frischerZucker/trichter/README.md

# SMART-TRICHTER

## Setup
This project uses [u8g2](https://github.com/olikraus/u8g2) as graphiics library.
Clone it to your machine and copy its include (\*.h) and source (\*.c) files from `u8g2/csrc` to `./software/trichter_firmware/Inc` and  `./software/trichter_firmware/.`
