frischerZucker/trichter/hardware/trichter_bom.xlsx

Anzahl Boards: | 2 | Lieferant | Teilenummer | Beschreibung | Stück pro Board | Stück benötigt | Stückpreis | Preis
 |  | Digikey | 1597-1517-ND | flow sensor | 1 | 3 | 6.90 € | 20.70 €
Gesamtpreis: | 75.04 € | Digikey | 2073-USB4110-GF-A-1-ND | USB-C receptacle | 1 | 3 | 1.27 € | 3.81 €
 |  | Digikey | CKN9087CT-ND | button | 5 | 11 | 0.31 € | 3.44 €
 |  | Digikey | 2449-ANT11SF1CQE-ND | switch | 1 | 3 | 2.36 € | 7.08 €
 |  | Digikey | AP7361C-33E-13DICT-ND | voltage regulator 5V -> 3.3V | 1 | 3 | 0.55 € | 1.65 €
 |  | Digikey | 497-STM32C051K8T6-ND | microcontroller | 1 | 3 | 1.60 € | 4.80 €
 |  | Digikey | 475-KBEELP41.12-P1R2-36-3X4X-5-R18CT-ND | LED, 5mA@2.75V | 2 | 5 | 0.18 € | 0.90 €
 |  | Digikey | 490-10503-1-ND | C, 10uF | 25 | 51 | 0.10 € | 5.05 €
 |  | Digikey | 1276-1248-1-ND | C, 4.7uF | 25 | 51 | 0.11 € | 5.42 €
 |  | Digikey | 1276-1033-1-ND | C, 100nF | 25 | 51 | 0.02 € | 1.19 €
 |  | Digikey | RMCF0603FT10K0CT-ND | R, 10k | 25 | 51 | 0.01 € | 0.61 €
 |  | Digikey | RMCF0603FT5K10CT-ND | R, 5.1k | 25 | 51 | 0.01 € | 0.61 €
 |  | Digikey | RMCF0603FT390RCT-ND | R, 390 | 25 | 51 | 0.01 € | 0.61 €
 |  | Digikey | 2057-PH1-20-UA-ND | Pinheader 01x20 | 5 | 11 | 0.22 € | 2.44 €
 |  | Digikey | 35-PRPC010DAAN-RC-ND | Pinheader 02x10 | 5 | 11 | 0.33 € | 3.58 €
 |  | Digikey | M7581-46-ND | Jumper | 18 | 37 | 0.06 € | 2.37 €
 |  | Digikey | 4272-PTS-00210-211-ND | USB to UART | 0 | 1 | 10.78 € | 10.78 €
