frischerZucker/trichter/software/trichter_firmware/Src/main.c

#include "main.h"

#include "stdio.h"
#include "string.h"

#include "display.h"
#include "flash.h"
#include "flow_sensor.h"
#include "menu.h"
#include "trichter_state.h"
#include "user_profile.h"

#define ENCODER_DEBOUNCE_TIME_MS 50

static I2C_HandleTypeDef hi2c1;

static UART_HandleTypeDef huart1;

static flow_sensor_state_t flow_sensor;

static trichter_state_t state = STATE_IDLE;

static bool btn_back = false;
static bool last_btn_back = false;
static bool btn_confirm = false;
static bool last_btn_confirm = false;

static bool drinking_started = false;

static bool display_dirty = true;

static uint32_t encoder_last_tick = 0;
static int encoder_delta = 0;

static char new_user_name[USER_PROFILE_MAX_NAME_LEN + 1];
static size_t new_user_name_idx;

static void system_clock_init(void)
{
	RCC_OscInitTypeDef RCC_OscInitStruct =
	{ 0 };
	RCC_ClkInitTypeDef RCC_ClkInitStruct =
	{ 0 };

	__HAL_FLASH_SET_LATENCY(FLASH_LATENCY_0);

	RCC_OscInitStruct.OscillatorType = RCC_OSCILLATORTYPE_HSI;
	RCC_OscInitStruct.HSIState = RCC_HSI_ON;
	RCC_OscInitStruct.HSIDiv = RCC_HSI_DIV1;
	RCC_OscInitStruct.HSICalibrationValue = RCC_HSICALIBRATION_DEFAULT;
	if (HAL_RCC_OscConfig(&RCC_OscInitStruct) != HAL_OK)
	{
		Error_Handler();
	}

	RCC_ClkInitStruct.ClockType = RCC_CLOCKTYPE_HCLK | RCC_CLOCKTYPE_SYSCLK | RCC_CLOCKTYPE_PCLK1;
	RCC_ClkInitStruct.SYSCLKSource = RCC_SYSCLKSOURCE_HSI;
	RCC_ClkInitStruct.SYSCLKDivider = RCC_SYSCLK_DIV1;
	RCC_ClkInitStruct.AHBCLKDivider = RCC_HCLK_DIV1;
	RCC_ClkInitStruct.APB1CLKDivider = RCC_APB1_DIV1;

	if (HAL_RCC_ClockConfig(&RCC_ClkInitStruct, FLASH_LATENCY_0) != HAL_OK)
	{
		Error_Handler();
	}
}

static void i2c_init(void)
{
	hi2c1.Instance = I2C1;
	hi2c1.Init.Timing = 0x0090194B;
	hi2c1.Init.OwnAddress1 = 0;
	hi2c1.Init.AddressingMode = I2C_ADDRESSINGMODE_7BIT;
	hi2c1.Init.DualAddressMode = I2C_DUALADDRESS_DISABLE;
	hi2c1.Init.OwnAddress2 = 0;
	hi2c1.Init.OwnAddress2Masks = I2C_OA2_NOMASK;
	hi2c1.Init.GeneralCallMode = I2C_GENERALCALL_DISABLE;
	hi2c1.Init.NoStretchMode = I2C_NOSTRETCH_DISABLE;
	if (HAL_I2C_Init(&hi2c1) != HAL_OK)
	{
		Error_Handler();
	}

	if (HAL_I2CEx_ConfigAnalogFilter(&hi2c1, I2C_ANALOGFILTER_ENABLE) != HAL_OK)
	{
		Error_Handler();
	}

	if (HAL_I2CEx_ConfigDigitalFilter(&hi2c1, 0) != HAL_OK)
	{
		Error_Handler();
	}
}

static void uart_init(void)
{
	huart1.Instance = USART1;
	huart1.Init.BaudRate = 115200;
	huart1.Init.WordLength = UART_WORDLENGTH_8B;
	huart1.Init.StopBits = UART_STOPBITS_1;
	huart1.Init.Parity = UART_PARITY_NONE;
	huart1.Init.Mode = UART_MODE_TX_RX;
	huart1.Init.HwFlowCtl = UART_HWCONTROL_NONE;
	huart1.Init.OverSampling = UART_OVERSAMPLING_16;
	huart1.Init.OneBitSampling = UART_ONE_BIT_SAMPLE_DISABLE;
	huart1.Init.ClockPrescaler = UART_PRESCALER_DIV1;
	huart1.AdvancedInit.AdvFeatureInit = UART_ADVFEATURE_NO_INIT;
	if (HAL_UART_Init(&huart1) != HAL_OK)
	{
		Error_Handler();
	}
	if (HAL_UARTEx_SetTxFifoThreshold(&huart1, UART_TXFIFO_THRESHOLD_1_8) != HAL_OK)
	{
		Error_Handler();
	}
	if (HAL_UARTEx_SetRxFifoThreshold(&huart1, UART_RXFIFO_THRESHOLD_1_8) != HAL_OK)
	{
		Error_Handler();
	}
	if (HAL_UARTEx_DisableFifoMode(&huart1) != HAL_OK)
	{
		Error_Handler();
	}
}

static void gpio_init(void)
{
	GPIO_InitTypeDef GPIO_InitStruct =
	{ 0 };

	__HAL_RCC_GPIOA_CLK_ENABLE();
	__HAL_RCC_GPIOB_CLK_ENABLE();

	GPIO_InitStruct.Pin = PIN_IO0 | PIN_BTN_CONFIRM | PIN_ENCODER_PUSH | PIN_ENCODER_B;
	GPIO_InitStruct.Mode = GPIO_MODE_INPUT;
	GPIO_InitStruct.Pull = GPIO_NOPULL;
	HAL_GPIO_Init(PORT_IO0, &GPIO_InitStruct);

	GPIO_InitStruct.Pin = PIN_FLOW_PULSE | PIN_ENCODER_A;
	GPIO_InitStruct.Mode = GPIO_MODE_IT_RISING;
	GPIO_InitStruct.Pull = GPIO_NOPULL;
	HAL_GPIO_Init(PORT_FLOW_PULSE, &GPIO_InitStruct);

	GPIO_InitStruct.Pin = PIN_BTN_BACK | PIN_IO5 | PIN_IO4 | PIN_IO3 | PIN_IO2 | PIN_IO1;
	GPIO_InitStruct.Mode = GPIO_MODE_INPUT;
	GPIO_InitStruct.Pull = GPIO_NOPULL;
	HAL_GPIO_Init(PORT_BTN_BACK, &GPIO_InitStruct);

	HAL_NVIC_SetPriority(EXTI0_1_IRQn, 0, 0);
	HAL_NVIC_EnableIRQ(EXTI0_1_IRQn);

	HAL_NVIC_SetPriority(EXTI4_15_IRQn, 0, 0);
	HAL_NVIC_EnableIRQ(EXTI4_15_IRQn);
}

static void menu_callback_remove_user(void)
{
	user_profile_remove_current_user();

	display_set_view(VIEW_IDLE);
	state = STATE_IDLE;
}

static void menu_callback_add_user(void)
{
	new_user_name_idx = 0;
	strncpy(new_user_name, "a---------", USER_PROFILE_MAX_NAME_LEN + 1);
	display_set_new_user_name(new_user_name);

	display_set_view(VIEW_USER_CREATION);
	state = STATE_USER_CREATION;
}

static void menu_callback_read_flash(void)
{
	void *address = FLASH_USER_PAGE_BASE_ADDRESS - PAGESIZE;

	uint64_t data[2];
	flash_read(address, data, 2);

	team_profile->all_time_volume_ul = data[0];
	team_profile->attempt_counter = data[1];
}

static void menu_callback_write_flash(void)
{
	void *address = FLASH_USER_PAGE_BASE_ADDRESS - PAGESIZE;

	uint64_t data[2];
	data[0] = team_profile->all_time_volume_ul + 1000;
	data[1] = team_profile->attempt_counter + 2;

	flash_clear_page(address);
	flash_write(address, data, 2);
}

static void process_user_input(void)
{
	if (encoder_delta != 0)
	{
		bool cycle_direction = encoder_delta > 0;

		switch (state) {
			case STATE_IDLE:
				user_profile_cycle_profiles(cycle_direction);

				display_dirty = true;
				break;

			case STATE_MENU:
				menu_cycle_selected_entry(cycle_direction);

				display_dirty = true;
				break;

			case STATE_USER_CREATION:
				/* Cycle between characters. Skip unprintable characters. */
				new_user_name[new_user_name_idx] = new_user_name[new_user_name_idx] + encoder_delta;
				if (new_user_name[new_user_name_idx] > '~')
				{
					new_user_name[new_user_name_idx] = ' ';
				}
				else if (new_user_name[new_user_name_idx] < ' ')
				{
					new_user_name[new_user_name_idx] = '~';
				}
				display_dirty = true;
				break;

			default:
				break;
		}

		encoder_delta = 0;
	}

	btn_back = !HAL_GPIO_ReadPin(PORT_BTN_BACK, PIN_BTN_BACK);
	if (btn_back && last_btn_back == false)
	{
		switch (state) {
			case STATE_IDLE:
				/* Open the menu. */
				state = STATE_MENU;
				display_set_view(VIEW_MENU);
				break;

			case STATE_MENU:
				/* Close the menu. */
				state = STATE_IDLE;
				display_set_view(VIEW_IDLE);
				break;

			case STATE_USER_CREATION:
				state = STATE_IDLE;
				display_set_view(VIEW_IDLE);
				break;

			case STATE_RUNNING:
				/* Discard the try. */
				state = STATE_IDLE;
				display_set_view(VIEW_IDLE);
				break;

			default:
				break;
		}
		display_dirty = true;
	}
	last_btn_back = btn_back;

	btn_confirm = !HAL_GPIO_ReadPin(PORT_BTN_CONFIRM, PIN_BTN_CONFIRM);
	if (btn_confirm && last_btn_confirm == false)
	{
		switch (state) {
			case STATE_IDLE:
				// Change the displayed stat if the leaderboard is selected.
				if (selected_profile->id == USER_ID_LEADERBOARD)
				{
					display_cycle_leader_board();
				}
				// Start a measurement if a real profile is selected.
				else
				{
					selected_profile->volume_ul = 0;
					selected_profile->start_time_ms = HAL_GetTick();
					flow_sensor_reset(&flow_sensor);

					drinking_started = false;

					state = STATE_RUNNING;
					display_set_view(VIEW_RUNNING);
				}
				break;

			case STATE_MENU:
				menu_entries[menu_selected_entry_idx].action();
				display_dirty = true;
				break;

			case STATE_USER_CREATION:
				/* Edit the next character of the new user name. */
				new_user_name_idx = new_user_name_idx + 1;
				if (new_user_name_idx < USER_PROFILE_MAX_NAME_LEN)
				{
					new_user_name[new_user_name_idx] = ' ';
				}
				/* Create a profile when the names last character is confirmed. */
				else
				{
					user_profile_add_user(new_user_name);
					display_set_view(VIEW_IDLE);
					state = STATE_IDLE;
				}
				display_dirty = true;
				break;

			case STATE_RUNNING:
				// Discard the attempt if nothing was drunken.
				if (selected_profile->volume_ul == 0)
				{
					state = STATE_IDLE;
					display_set_view(VIEW_IDLE);
					break;
				}

				selected_profile->all_time_volume_ul = selected_profile->all_time_volume_ul + selected_profile->volume_ul;
				selected_profile->attempt_counter = selected_profile->attempt_counter + 1;

				// Normalize the time of the attempt to ms per l to make them comparable. -> ms * 1000 / (ul / 1000) = us / ml = ms / l
				size_t s_per_l = (selected_profile->end_time_ms - selected_profile->start_time_ms) * 1000 / (selected_profile->volume_ul / 1000);
				if (s_per_l < selected_profile->fastest_attempt_ms_per_l)
				{
					selected_profile->fastest_attempt_ms_per_l = s_per_l;
				}

				if (selected_profile->id != USER_ID_TEAM)
				{
					team_profile->all_time_volume_ul = team_profile->all_time_volume_ul + selected_profile->volume_ul;
					team_profile->attempt_counter = team_profile->attempt_counter + 1;

					if (s_per_l < team_profile->fastest_attempt_ms_per_l)
					{
						team_profile->fastest_attempt_ms_per_l = s_per_l;
					}
				}

				user_profile_update_leader_board();

				state = STATE_IDLE;
				display_set_view(VIEW_IDLE);
				break;

			default:
				break;
		}
		display_dirty = true;
	}
	last_btn_confirm = btn_confirm;

	/*
	 * Pushing the encoder button sometimes triggers the flow sensor, glitches the display and/or crashes the device...
	 * Most of the time it does nothing. -> Is it really clicking? In a review the buttons casing was too large.
	 * Right now idk why, so just dont push the button i guess. ¯\_(ツ)_/¯
	 */
//	btn_push = !HAL_GPIO_ReadPin(PORT_ENCODER_PUSH, PIN_ENCODER_PUSH);
//	if (btn_push && last_btn_push == false)
//	{
//		display_increment_counter();
//		display_dirty = true;
//	}
//	last_btn_push = btn_push;
}

void HAL_GPIO_EXTI_Rising_Callback(uint16_t gpio_pin)
{
	switch (gpio_pin) {
		case PIN_FLOW_PULSE:
			flow_sensor_interrupt(&flow_sensor);
			break;

		case PIN_ENCODER_A:
			uint32_t now = HAL_GetTick();
			if (now - encoder_last_tick < ENCODER_DEBOUNCE_TIME_MS)
			{
				break;
			}
			encoder_last_tick = now;

			/* counter-clockwise rotation */
			if (HAL_GPIO_ReadPin(PORT_ENCODER_B, PIN_ENCODER_B))
			{
				encoder_delta = encoder_delta - 1;
			}
			/* clockwise rotation */
			else
			{
				encoder_delta = encoder_delta + 1;
			}

			break;

		default:
			break;
	}
}

int main(void)
{
	HAL_Init();

	system_clock_init();
	i2c_init();
	uart_init();
	gpio_init();

	display_init(&hi2c1, 0x3c);

	flow_sensor_init(&flow_sensor);

	user_profile_init();
//	user_profile_add_user("Rote Beete");
	user_profile_add_user("John");
	user_profile_add_user("Dr. Doe");

	menu_init();
	menu_add_entry("New profile", menu_callback_add_user);
	menu_add_entry("Del profile", menu_callback_remove_user);
	menu_add_entry("Reset", HAL_NVIC_SystemReset);

	menu_add_entry("read", menu_callback_read_flash);
	menu_add_entry("write", menu_callback_write_flash);

	display_set_view(VIEW_IDLE);

	while (1)
	{
		process_user_input();

		switch (state) {
			case STATE_IDLE:
				break;

			case STATE_RUNNING:
				if (flow_sensor_update(&flow_sensor))
				{
					// Set the start time when a volume flow is detected for the first time after the measurement was started.
					if (drinking_started == false)
					{
						selected_profile->start_time_ms = HAL_GetTick();
						drinking_started = true;
					}

					selected_profile->volume_ul = flow_sensor_get_volume_ul(&flow_sensor);
					selected_profile->end_time_ms = HAL_GetTick();
					display_set_is_flowing(flow_sensor.is_flowing);
					display_dirty = true;
				}

				break;
			default:
				break;
		}

		if (display_dirty)
		{
			display_draw_view();
			display_dirty = false;
		}
	}
}

void Error_Handler(void)
{
	__disable_irq();
	while (1)
	{
	}
}
