frischerZucker/trichter/software/trichter_firmware/Inc/trichter_state.h

/*
 * trichter_state.h
 *
 *  Created on: Oct 10, 2026
 *      Author: moritz
 */

#ifndef TRICHTER_STATE_H_
#define TRICHTER_STATE_H_

typedef enum
{
	STATE_IDLE = 0,
	STATE_RUNNING,
	STATE_MENU,
	STATE_USER_CREATION,
} trichter_state_t;

#endif /* TRICHTER_STATE_H_ */
