frischerZucker/trichter/(commit log)

2026-08-18 Add schematics.
    [microcontroller.kicad_sch, power.kicad_sch, trichter.kicad_pcb, trichter.kicad_sch]
2026-08-21 Layout & Routing.
    [microcontroller.kicad_sch, power.kicad_sch, trichter.kicad_pcb, trichter.kicad_sch]
2026-08-22 Export gerber files and add BOM.
    [power.kicad_sch, trichter.kicad_pcb, trichter.kicad_sch, trichter_bom.xlsx]
2026-09-04 Implement flow sensor module for the breadboard prototype.
    This should be quite easy to transfer to the real chip because of the HAL.
2026-09-11 Print schematics to pdf.
2026-09-12 Create project for the real board and add flow sensor code.
2026-09-12 Add driver code (wip) for the display.
2026-10-09 Implement buttons of the display module.
2026-10-09 Speed up system clock and I2C.
    Set system clock to 48 MHz and switch to I2C fast mode.
2026-10-09 Implement rotary encoder.
    The encoders push button is not working.
    [main.c, main.h]
2026-10-10 Implement button to cancel a try.
    Discards the measured volume and does not increase the attempt counter.
2026-10-10 Implement mene view (currently empty..) & headers for each view.
2026-10-17 Add leader boards.
